Frupla/ECU-board/README.md

# ECU-board

We are making history! Or at least a working car.
