Frupla/ECU-board/Noter for at compile.txt

Slet FlexCAN.h + FlexCAN.cpp fra standard arduino libraries (Program files eller noget), og benyt istedet det fra ecocar's git.
