Frupla/ECU-board/fagprojektmidtvejs_1.png

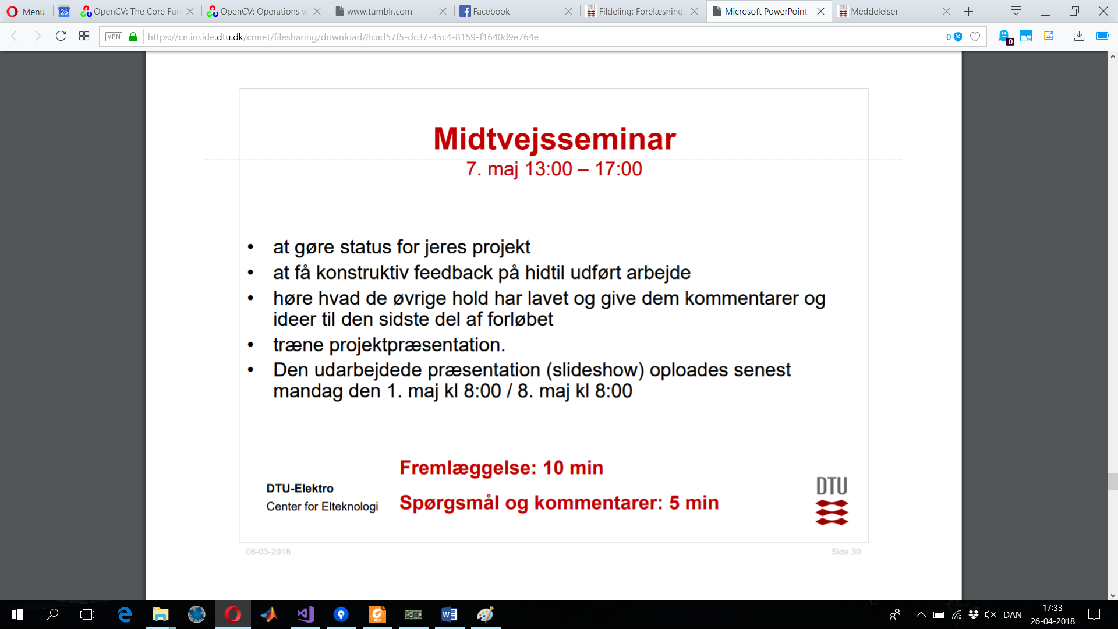
fagprojektmidtvejs_1.png
