Frupla/ECU-board/fagprojektmidtvejs_2.png

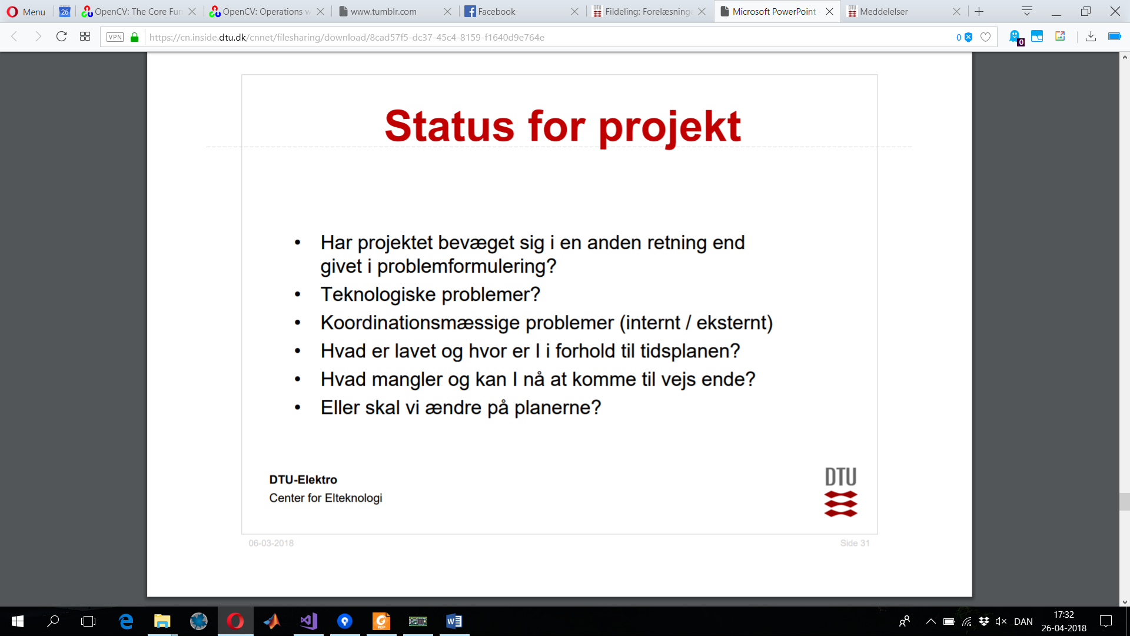
fagprojektmidtvejs_2.png
