Frupla/ECU-board/Calibration.txt

--------------------------------------------------------------
--------------------------------------------------------------
System Status
--------------------------------------------------------------
--------------------------------------------------------------

--------------------------------------------------------------
FPGA Errors
--------------------------------------------------------------
Encoder Error	= 0
Dwell Error	= 0
Watchdog Error	= 0

--------------------------------------------------------------
Realtime Errors
--------------------------------------------------------------
Network Safety Shutdown	= 0
FPGA Safety Shutdown	= 0
Board Safety Shutdown	= 0
Internal Communication Shutdown	= 0
Calibration Manager Error	= 0
VISA Send Error	= 0
VISA Read Error	= 0
Petter Safety Shutdown	= 0
Log Error	= 0
Error Code	= 1073676288
Error Source	= 

--------------------------------------------------------------
Running Setup
--------------------------------------------------------------
Closed Loop	= 0
Automatic Gear	= 0
Idle		= 0
Burn		= 0
Gear		= 1

--------------------------------------------------------------
--------------------------------------------------------------
Calibration Parameters
--------------------------------------------------------------
--------------------------------------------------------------

--------------------------------------------------------------
Engine Position Calc
--------------------------------------------------------------
Engine Calibration	= 360

--------------------------------------------------------------
Ignition Control
--------------------------------------------------------------
Ignition Dwell Time - ms	= 3
Max. Ign. Dwell Time  - ms	= 9
Engine Revolution Limit - RPM	= 5000

--------------------------------------------------------------
Ignition Map
--------------------------------------------------------------
Engine Revolutions - RPM	Ignition Timing - CAD BTDC
0					20
250					20
500					20
750					20
1000				20
1250				20
1500				20
1750				25
2000				25
2250				25
2500				30
2750				30
3000				3
03250				30
3500				35
3750				35
4000				35
4250				35
4500				35
4750				40
5000				40
5250				40
5500				40
5750				40
6000				45

--------------------------------------------------------------
Gear Control
--------------------------------------------------------------
Gear Change Wait - ms		= 150
Gear Change Limit - RPM		= 2800
Neutral Gear Position - µs	= 178
First Gear Position - µs	= 200
Secondd Gear Position - µs	= 150

--------------------------------------------------------------
Starter Control
--------------------------------------------------------------
Starter Limit - RPM	= 900

--------------------------------------------------------------
Injection Control
--------------------------------------------------------------
Injection Timing - CAD BTDC	= 180
Fuel Conversion Slope - µg/µs	= 0.780000
Fuel Conversion Intercept - µg	= 810.000000

--------------------------------------------------------------
Injection Map
--------------------------------------------------------------
Engine Revolutions - RPM	Injection Length - µs
0					6000
250					4967
500					5214
750					6000
1000				6000
1250				4932
1500				6000
1750				4867
2000				4526
2250				4597
2500				4592
2750				4536
3000				4365
3250				4289
3500				4421
3750				4446
4000				4384
4250				4306
4500				4460
4750				4528
5000				4500
5250				4500
5500				4500
5750				4500
6000				4500

--------------------------------------------------------------
Closed Loop Control
--------------------------------------------------------------
Excess Air Ratio Slope - 1/V	= 0.246000
Excess Air Ratio Offset		= 0.250000
Excess Air Ratio Delay - ms	= 350
Stoichiometric Air Fuel Ratio	= 9.000000
PID Output Lower Limit		= 3000.000000
PID Output Upper Limit		= 6000.000000
PID Proportional Gain		= 0.500000
PID Integral Gain		= 0.000000
PID Derivative Gain		= 0.000000
PID Filter Coefficient		= 0.000000

--------------------------------------------------------------
Excess Air Ratio Map
--------------------------------------------------------------
Engine Revolutions - RPM	Excess Air Ratio
0				1.300
0				1.300
0				1.300
0				1.300
0				1.300
0				1.300
0				1.300
0				1.300
0				1.300
0				1.300
0				1.300
0				1.300
0				1.300
0				1.300
0				1.300
0				1.300
0				1.300
0				1.300
0				1.300
0				1.300
0				1.300
0				1.300
0				1.300
0				1.300
0				1.300

--------------------------------------------------------------
FPGA Watchdog & Petter
--------------------------------------------------------------
FPGA Petter Timeout - ms	= 500
FPGA Watchdog Timeout - ms	= 500

--------------------------------------------------------------
Automatic Gear
--------------------------------------------------------------
First to Second gear velocity - km/h	= 15.0
Second to First gear velocity - km/h	= 13.0

--------------------------------------------------------------
Idle Control
--------------------------------------------------------------
Idle low limit - RPM	= 2200
Idle high limit - RPM	= 2000
Idle Injection - µs	= 9000

--------------------------------------------------------------
Speed Calc
--------------------------------------------------------------
Wheel Diameter - mm		= 550
Wheel Pulses pr. Rev		= 15
Rolling Road Roll Diameter - mm	= 0
Rolling Road Pulses pr. Rev	= 0
Realistic Speed Limit - km/h	= 100

--------------------------------------------------------------
Consumption Calc
--------------------------------------------------------------
Fuel Amount - ml		= 250
Fuel Density - g/L		= 789
Fuel Lower Heating Value - kJ/kg	= 26803
Equivalent Fuel Density - g/L		= 748
Equivalent Fuel Lower Heating Value - kJ/kg	= 43800

--------------------------------------------------------------
VISA Setup
--------------------------------------------------------------
Visa Port	= ASRL1::INSTR
Baudrate	= 19200
Timeout - s	= 100
