Frupla/ECU-board/ECU2018/ECU2018/sources/Encoder-master/Encoder.cpp

#include "Encoder.h"

// Yes, all the code is in the header file, to provide the user
// configure options with #define (before they include it), and
// to facilitate some crafty optimizations!

//Encoder_internal_state_t * Encoder::interruptArgs[];
// Asger(2) - Måske fik dette den til at compile...
