Frupla/ECU-board/ECU2018/ECU2018/sources/injection.cpp

// Frederik Ettrup Larsen s163920
// 20/4/2018
// 

#include "injection.h"


#define inject_pin 20//Might be 20, if it is "dyse" which I'm assuming it is
//Constants
//for the calculation of the mass of fuel based on time
float slope = 0.78;
float interjection = 810.0;
// m = slope * t + interjection
float MAXRPM = 4000.0; //Should be given by the mek's

INTERPOL injection;

void initializeInjection() {
	pinMode(inject_pin, OUTPUT);
	TeensyDelay::addDelayChannel(stopInj, INJECTION_CHANNEL);
	stopInj();
}

void setSlope(float newSlope) {
	slope = newSlope;
}

void setInterjection(float newInterjection) {
	interjection = newInterjection;
}

void setMAXRPM(float newMAXRPM) {
	MAXRPM = newMAXRPM;
}

int canRun(double RPM) {
	if (RPM > MAXRPM || RPM == -1){
		return 0;
	}
	else {
		return 1;
	}
}


double findTime_injection(double RPM, float potentiometer) {
	injection = interpolation_map(RPM);
	double xhigh = injectionArray[injection.upper];
	double xlow = injectionArray[injection.lower];
	double xinc = injection.increment;
	double time = (xhigh - xlow)*xinc + xlow;
	return time*potentiometer;
}

void startInj(){
	digitalWrite(inject_pin, HIGH); //Sends signal to start injection
}

void stopInj() {
	digitalWrite(inject_pin, LOW); //Sends signal to stop injection
}

float calcMass(long angle){
	return slope * angle + interjection; //calculate mass of fuel based on angle which correlates to time trust me guys
}

bool injectionCheck(char startAngle, double  time, char posAngle){
	if (!digitalRead(inject_pin) && (posAngle >= startAngle && posAngle <= startAngle + 10)) {
		startInj();
		TeensyDelay::trigger(time, INJECTION_CHANNEL);
		return false;
	}
	else {
		return true;
	}
} 
