Frupla/ECU-board/ECU2018/ECU2018/sources/injection.h

// injection.h

#ifndef _INJECTION_h
#define _INJECTION_h

#if defined(ARDUINO) && ARDUINO >= 100
	#include "arduino.h"
#else
	#include "WProgram.h"
#endif

#include "ingAndinjArray.h"
#include "TeensyDelay.h"

#define INJECTION_CHANNEL 1

//functioner
void initializeInjection();
int canRun(double RPM);
bool injectionCheck(char start, double time, char pos);
double findTime_injection(double RPM, float potentiometer);
void startInj();
void stopInj();
float calcMass(long time);
void setSlope(float newSlope);
void setInterjection(float newInterjection);
void setMAXRPM(float newMAXRPM);


#endif
