Frupla/ECU-board/ECU2018/ECU2018/sources/ingAndinjArray.h

// ingAndinjArray.h, yes this is the optimal name

#ifndef _INGANDINJARRAY_h
#define _INGANDINJARRAY_h

#if defined(ARDUINO) && ARDUINO >= 100
	#include "arduino.h"
#else
	#include "WProgram.h"
#endif


typedef struct INTERPOL {
	uint lower;
	uint upper;
	//uint close;
	double increment;
} INTERPOL;

extern uint32_t ignitionArray[25];
extern uint32_t injectionArray[25];
INTERPOL interpolation_map(double rpm);

#endif
