Frupla/ECU-board/ECU2018/ECU2018/sources/LEDs.h

/*
 * LEDs.h
 *
 * Author: Håkon Westh-Hansen
 * Created: 1/4/2017
 *
 */

#ifndef LEDs_H_
#define LEDs_H_

#define LED1 9
#define LED2 10
#define LED3 25
#define LED4 26


void LED_init();
void LED_on(uint8_t LED);
void LED_off(uint8_t LED);
void LED_toggle(uint8_t LED);
void LED_test();

#endif /* LEDs_H_ */
