Frupla/ECU-board/ECU2018/ECU2018/sources/rs232sync.h

/*
 * rs232sync.h
 *
 * Created: 20/06/2016 01:56:17
 *  Author: Henning
 */

#ifndef RS232SYNC_H_
#define RS232SYNC_H_

#include "global.h"
extern uint8_t emergency;
void rs232_set_car(uint8_t carId);
void rs232_tx();
void serialEvent3();

enum {
	RS232_STATE_WAITING,
	RS232_STATE_WAITING_FOR_SECOND_START,
	RS232_STATE_GET_PACKET_SIZE,
	RS232_STATE_RECEIVING
};

#endif /* RS232SYNC_H_ */
