Frupla/ECU-board/(commit log)

2018-04-16 Made an empty project, and copied the old motorcode into here.
2018-04-16 Lille note fil hvor der står hvad pins gør
2018-04-16 Strikket ecu kode sammen med motor kode fra sidste år
2018-04-16 Included the correct files
    [LEDs.cpp, adc.cpp, autoGear.cpp, bluetooth.cpp, global.cpp, inout.cpp, motorCAN.cpp, my_queue.cpp]
2018-04-16 initializes encoder
2018-04-20 Pin redefinitions
2018-04-20 Some support code for the encoder library, now embedded in the position.cpp and .h files
2018-04-20 An attempt at mechanical error reading, by fucking with Encoder.h
    [Encoder.h]
2018-04-21 Fixede Irenes errorbool i encoder.h, har fixet et par slåfejl og advarsler fra compileren. Kan ikke compile, men det skyldes nok ignition, injection og nogle manglende arrays
    [Encoder.h, ignition.cpp, ignition.h, ingAndinjArray.cpp, ingAndinjArray.h, injection.cpp, injection.h]
2018-04-22 Moved #include encoder to .h file Fixed scope problem
    [position.cpp, position.h]
2018-04-22 Små fikses her og der
2018-04-22 Encoder.h compilable
2018-04-22 Print af brændstof
2018-04-22 prototype på ny løsning
2018-04-22 lØSNIGSFORSLAG TIL eNCODER
2018-04-22 errorchecking with bitmasks - IT COMPILES!!
    [Encoder.h]
2018-04-23 Added a timer library (TeensyDelay)
2018-04-23 Implementering af injerction med timere, og fucken rundt i inginition
2018-04-23 Implented injection and ignition with timers (hopefully correctly)
    [ignition.cpp, ignition.h, injection.h]
2018-04-23 Compilable, and set for encoder test
2018-04-24 Updated encoder to the hardware encoder
2018-04-26 Minor decleration errors fixed
    [ECU2018.ino, QuadDecodeSimple.h, position.h]
2018-04-26 Calibration fra Frausing
2018-04-26 Doesn't injecet all the time
    [injection.cpp]
2018-04-26 Ordentlige værdier i ign og inj array
    [nemmereCopyPaste.csv]
2018-04-26 Decoder returns the correct
    [position.cpp]
2018-04-26 fjernet debugging print
2018-04-26 Updated the wheel encoder
2018-04-26 Removed the pullup resistor
2018-05-07 Muligt Encoder fix
2018-05-08 Fixed wheel position so it can have another offset than 0
    [position.cpp, position.h]
2018-05-11 Made interrupts work
